Unclerojelio/LED_Analyzer/docs/schematic.bmp

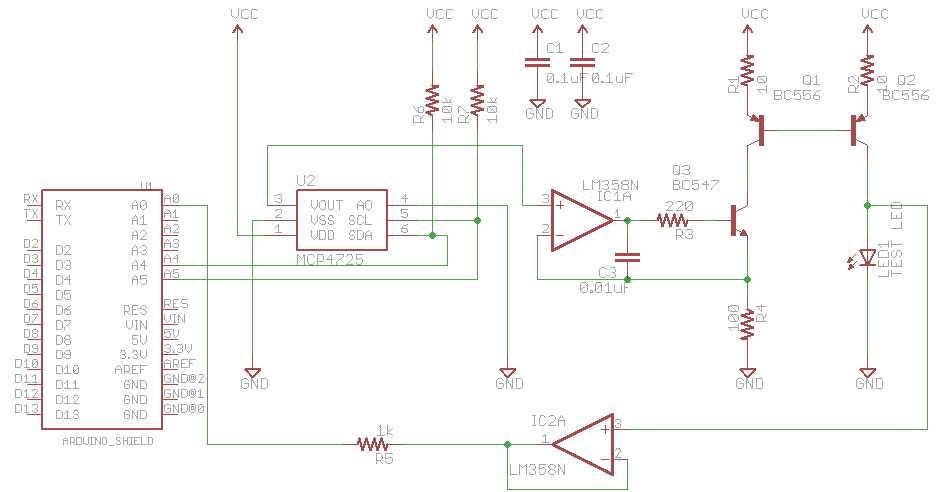
docs/schematic.bmp
