Unclerojelio/LED_Analyzer/LED_Analyzer.ino

//     Arduino code to support LED Analyzer Python script
//
//    Copyright (C) 2011  bitrex@earthlink.net
//
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
// Modified 19 Aug 2021 by Roger Banks
// Updated code to work with latest version of Wire.h 

#include <Wire.h>

#define MCP4725_ADDRESS 0x60
#define MCP4725_PROGRAM 0x40
#define VOLTAGE_RANGE (4095/5)*3
#define ANALOG_PIN A0

void setup() {

  Serial.begin(9600);
  Wire.begin();

}

void loop() {

  char startByte = '!';
  
  Wire.beginTransmission(MCP4725_ADDRESS);
  Wire.write(MCP4725_PROGRAM);
  Wire.write(0x0);
  Wire.write(0x0);
  Wire.endTransmission();
 
  if (Serial.available() > 0){
    
      if (startByte == Serial.read()){
        Serial.write(startByte);
        Blink();
        runTest();
      }
  }
}
   

void runTest() {

  unsigned int dataValue = 0;
  char endByte = '!';

  for (unsigned int i = 0; i < VOLTAGE_RANGE; i++){

    Wire.beginTransmission(MCP4725_ADDRESS);
    Wire.write(MCP4725_PROGRAM);
    Wire.write((unsigned char)((i & 0xFF0) >> 4));
    Wire.write((unsigned char)((i & 0xF) << 4));
    Wire.endTransmission();

    delay(1);

    dataValue = analogRead(ANALOG_PIN);

    Serial.write((unsigned char)((dataValue & 0x3FC) >> 2)); // high byte
    Serial.write((unsigned char)(dataValue & 0x3)); //low bits

  }
  
  Serial.write(endByte);
  Blink();
  while(1);
  
} 

void Blink() {

  for (unsigned char i = 0; i < 3; i++){

    Wire.beginTransmission(MCP4725_ADDRESS);
    Wire.write(MCP4725_PROGRAM);
    Wire.write(0x7F);
    Wire.write(0x0);
    Wire.endTransmission();
    delay(200); 
    Wire.beginTransmission(MCP4725_ADDRESS);
    Wire.write(MCP4725_PROGRAM);
    Wire.write(0x0);
    Wire.write(0x0);
    Wire.endTransmission();
    delay(200);
  }
}
